VirtualGit/HomeCockpitA320/Images/fcu/pcb-display.png

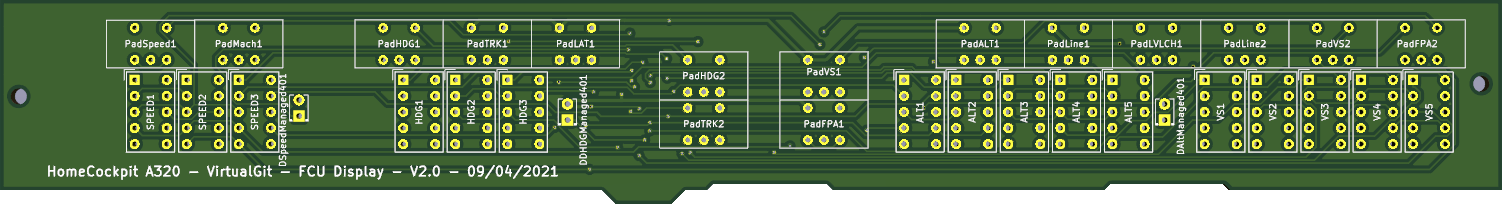
Images/fcu/pcb-display.png
