VirtualGit/HomeCockpitA320/Images/fcu/pcb-mb.png

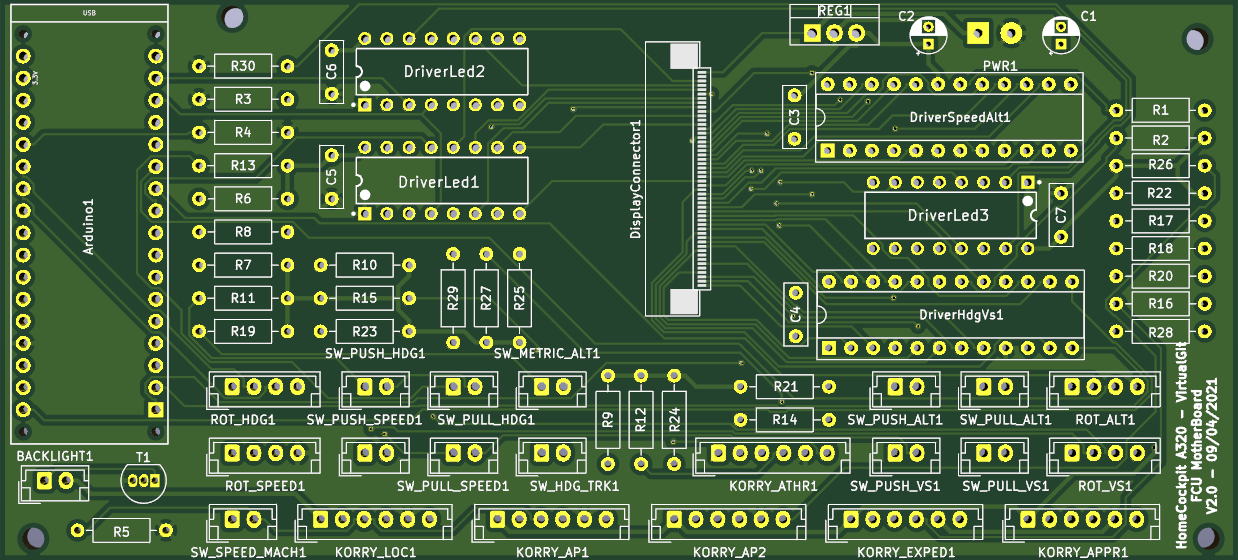
Images/fcu/pcb-mb.png
