VirtualGit/HomeCockpitA320/Electronic/fcu/fcu-mb.kicad_pcb

## KiCad design Electronic/fcu/fcu-mb.kicad_pcb (2021-04-11)

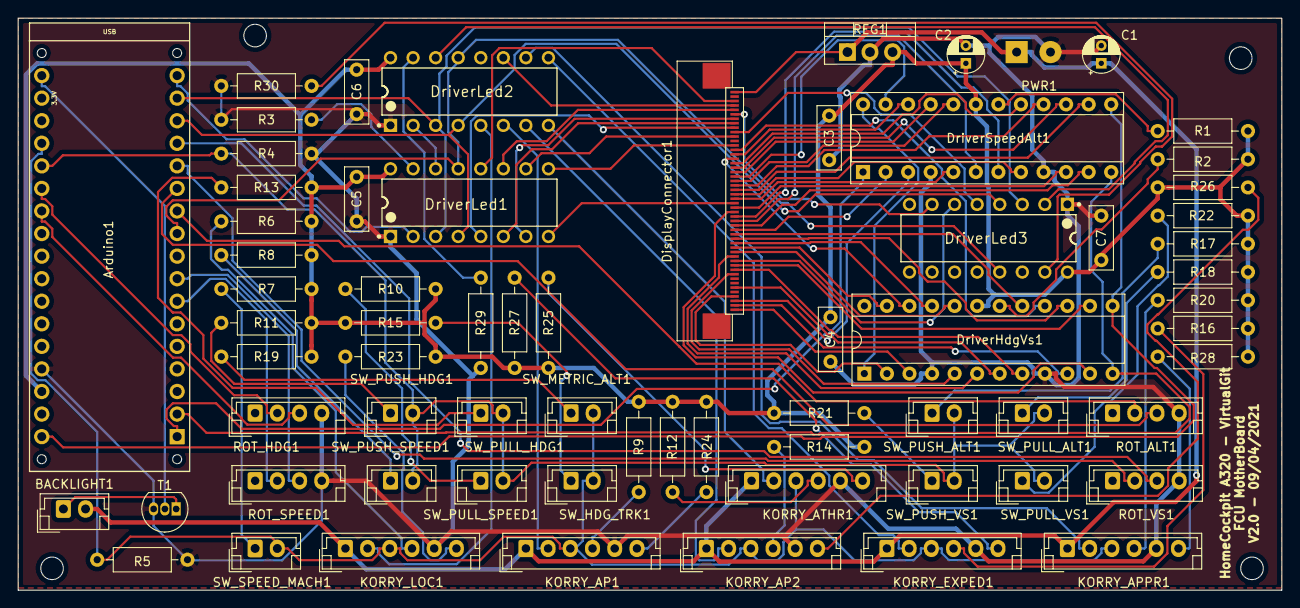
[picture p3: board fcu-mb.kicad_pcb from above]

Board: 2 copper layers, 142.2 x 64.4 mm, 69 parts (0 on the bottom side), 103 nets.

Parts:
Arduino1: Arduino_Nano_v3.x; Arduino_Micro_Socket
BACKLIGHT1: Conn_01x02_Male; JST_EH_B2B-EH-A_1x02_P2.50mm_Vertical
C1: 100µF; CP_Radial_D4.0mm_P2.00mm
C2: 10µF; CP_Radial_D4.0mm_P2.00mm
C3, C4: 0,1µF; C_Disc_D7.0mm_W2.5mm_P5.00mm
C5, C6, C7: 1µF; C_Disc_D7.0mm_W2.5mm_P5.00mm
DisplayConnector1: Connector-FPC-50pins; Connector-FPC-50pins-0.5mm
DriverHdgVs1: MAX7219; DIP-24_W7.62mm_Socket
DriverLed1, DriverLed2, DriverLed3: TLC5917IN; Texas_Instruments-TLC5917IN-Manufacturer_Recommended
DriverSpeedAlt1: MAX7219; DIP-24_W7.62mm_Socket
KORRY_AP1, KORRY_AP2: Korry; JST_EH_B6B-EH-A_1x06_P2.50mm_Vertical
KORRY_APPR1: Korry; JST_EH_B6B-EH-A_1x06_P2.50mm_Vertical
KORRY_ATHR1: Korry; JST_EH_B6B-EH-A_1x06_P2.50mm_Vertical
KORRY_EXPED1: Korry; JST_EH_B6B-EH-A_1x06_P2.50mm_Vertical
KORRY_LOC1: Korry; JST_EH_B6B-EH-A_1x06_P2.50mm_Vertical
PWR1: Conn_Coaxial_Power; SolderWirePad_1x02_P3.81mm_Drill1mm
R1, R2: 9,53kohms; R_Axial_DIN0207_L6.3mm_D2.5mm_P10.16mm_Horizontal
R3, R29: 1kohms; R_Axial_DIN0207_L6.3mm_D2.5mm_P10.16mm_Horizontal
R4, R5: 100kOhms; R_Axial_DIN0207_L6.3mm_D2.5mm_P10.16mm_Horizontal
R6, R13: 33kOhms; R_Axial_DIN0207_L6.3mm_D2.5mm_P10.16mm_Horizontal
R7, R8: 8,2kOhms; R_Axial_DIN0207_L6.3mm_D2.5mm_P10.16mm_Horizontal
R9, R22: 120kOhms; R_Axial_DIN0207_L6.3mm_D2.5mm_P10.16mm_Horizontal
R10, R15: 15kOhms; R_Axial_DIN0207_L6.3mm_D2.5mm_P10.16mm_Horizontal
R11, R19: 22kOhms; R_Axial_DIN0207_L6.3mm_D2.5mm_P10.16mm_Horizontal
R12, R17: 47kOhms; R_Axial_DIN0207_L6.3mm_D2.5mm_P10.16mm_Horizontal
R14: 150kOhms; R_Axial_DIN0207_L6.3mm_D2.5mm_P10.16mm_Horizontal
R16, R18: 68kOhms; R_Axial_DIN0207_L6.3mm_D2.5mm_P10.16mm_Horizontal
R20, R21: 91kOhms; R_Axial_DIN0207_L6.3mm_D2.5mm_P10.16mm_Horizontal
R23, R24, R25, R26, R27, R28: 100Ohms; R_Axial_DIN0207_L6.3mm_D2.5mm_P10.16mm_Horizontal
R30: 2kohms; R_Axial_DIN0207_L6.3mm_D2.5mm_P10.16mm_Horizontal
REG1: L7805; TO-220-3_Vertical
ROT_ALT1: Rotary_Encoder; JST_EH_B4B-EH-A_1x04_P2.50mm_Vertical_RotaryEncoder
ROT_HDG1: Rotary_Encoder; JST_EH_B4B-EH-A_1x04_P2.50mm_Vertical_RotaryEncoder
ROT_SPEED1: Rotary_Encoder; JST_EH_B4B-EH-A_1x04_P2.50mm_Vertical_RotaryEncoder
ROT_VS1: Rotary_Encoder; JST_EH_B4B-EH-A_1x04_P2.50mm_Vertical_RotaryEncoder
SW_HDG_TRK1: SW_Push; JST_EH_B2B-EH-A_1x02_P2.50mm_Vertical
SW_METRIC_ALT1: SW_Push; JST_EH_B2B-EH-A_1x02_P2.50mm_Vertical
SW_PULL_ALT1: SW_Push; JST_EH_B2B-EH-A_1x02_P2.50mm_Vertical
SW_PULL_HDG1: SW_Push; JST_EH_B2B-EH-A_1x02_P2.50mm_Vertical
SW_PULL_SPEED1: SW_Push; JST_EH_B2B-EH-A_1x02_P2.50mm_Vertical
SW_PULL_VS1: SW_Push; JST_EH_B2B-EH-A_1x02_P2.50mm_Vertical
SW_PUSH_ALT1: SW_Push; JST_EH_B2B-EH-A_1x02_P2.50mm_Vertical
SW_PUSH_HDG1: SW_Push; JST_EH_B2B-EH-A_1x02_P2.50mm_Vertical
SW_PUSH_SPEED1: SW_Push; JST_EH_B2B-EH-A_1x02_P2.50mm_Vertical
SW_PUSH_VS1: SW_Push; JST_EH_B2B-EH-A_1x02_P2.50mm_Vertical
SW_SPEED_MACH1: SW_Push; JST_EH_B2B-EH-A_1x02_P2.50mm_Vertical
T1: BS170; TO-92_Inline

Connections:
+5V: Arduino1.VIN, C2.1, C3.1, C4.1, C5.2, C6.2, C7.2, DriverHdgVs1.19, DriverLed1.16, DriverLed2.16, DriverLed3.16, DriverSpeedAlt1.19, R1.1, R2.1, R6.2, R7.2, R8.2, R9.2, R10.2, R11.2, R12.2, R13.2, R14.2, R15.2, R16.2, R17.2, R18.2, R19.2, R20.2, R21.2, R22.2, R23.2, R24.2, R25.2, R26.2, R27.2, R28.2, REG1.3
BTN_GRP_1: Arduino1.A0, KORRY_AP1.3, KORRY_AP2.3, KORRY_APPR1.3, KORRY_ATHR1.3, KORRY_EXPED1.3, KORRY_LOC1.3, R5.2, SW_HDG_TRK1.2, SW_METRIC_ALT1.2, SW_SPEED_MACH1.2
BTN_GRP_2: Arduino1.A1, R4.2, SW_PULL_ALT1.2, SW_PULL_HDG1.2, SW_PULL_SPEED1.2, SW_PULL_VS1.2, SW_PUSH_ALT1.2, SW_PUSH_HDG1.2, SW_PUSH_SPEED1.2, SW_PUSH_VS1.2
DriverDigitClock: Arduino1.SCK, DriverHdgVs1.13, DriverSpeedAlt1.13
DriverDigitData: Arduino1.MOSI, DriverSpeedAlt1.1
DriverDigitLoad: Arduino1.SS, DriverHdgVs1.12, DriverSpeedAlt1.12
DriverLedClock: Arduino1.D11, DriverLed1.3, DriverLed2.3, DriverLed3.3
DriverLedData: Arduino1.D12, DriverLed1.2
DriverLedLoad: Arduino1.D10, DriverLed1.4, DriverLed2.4, DriverLed3.4
GND: Arduino1.GND1, C1.2, C2.2, C3.2, C4.2, C5.1, C6.1, C7.1, DriverHdgVs1.4, DriverHdgVs1.9, DriverLed1.1, DriverLed2.1, DriverLed3.1, DriverSpeedAlt1.4, DriverSpeedAlt1.9, KORRY_AP1.5, KORRY_AP2.5, KORRY_APPR1.5, KORRY_ATHR1.5, KORRY_EXPED1.5, KORRY_LOC1.5, PWR1.2, R3.1, R4.1, R5.1, R29.1, R30.1, REG1.2, ROT_ALT1.C, ROT_HDG1.C, ROT_SPEED1.C, ROT_VS1.C, T1.3
LedKorryAP1: DriverLed2.6, KORRY_AP1.2
LedKorryAP2: DriverLed2.7, KORRY_AP2.2
LedKorryAPPR: DriverLed2.10, KORRY_APPR1.2
LedKorryATHR: DriverLed2.8, KORRY_ATHR1.2
LedKorryEXPED: DriverLed2.9, KORRY_EXPED1.2
LedKorryLoc: DriverLed2.5, KORRY_LOC1.2
LedManagedALT: DisplayConnector1.6, DriverLed3.7
LedManagedHDG: DisplayConnector1.39, DriverLed3.6
LedManagedSpeed: DisplayConnector1.10, DriverLed3.5
LedOutputEnable: Arduino1.D5, DriverLed1.13, DriverLed2.13, DriverLed3.13
LedPadFPA: DisplayConnector1.5, DriverLed1.11
LedPadHDG: DisplayConnector1.7, DriverLed1.7
LedPadLAT: DisplayConnector1.13, DriverLed1.9
LedPadMACH: DisplayConnector1.8, DriverLed1.6
LedPadSPD: DisplayConnector1.9, DriverLed1.5
LedPadStaticALT: DisplayConnector1.3, DriverLed1.12
LedPadStaticLines: DisplayConnector1.4, DriverLed2.11
LedPadTRK: DisplayConnector1.26, DriverLed1.8
LedPadVS: DisplayConnector1.11, DriverLed1.10
unnamed: Arduino1.D13, T1.2
unnamed: BACKLIGHT1.1, T1.1
unnamed: DriverHdgVs1.1, DriverSpeedAlt1.24
unnamed: DriverHdgVs1.18, R2.2
unnamed: DriverLed1.14, DriverLed2.2
unnamed: DriverLed1.15, R3.2
unnamed: DriverLed2.14, DriverLed3.2
unnamed: DriverLed2.15, R29.2
unnamed: DriverLed3.15, R30.2
unnamed: DriverSpeedAlt1.18, R1.2
unnamed: KORRY_AP1.4, R9.1
unnamed: KORRY_AP1.6, R24.1
unnamed: KORRY_AP2.4, R14.1
unnamed: KORRY_AP2.6, R26.1
unnamed: KORRY_APPR1.4, R20.1
unnamed: KORRY_APPR1.6, R28.1
unnamed: KORRY_ATHR1.4, R12.1
unnamed: KORRY_ATHR1.6, R25.1
unnamed: KORRY_EXPED1.4, R16.1
unnamed: KORRY_EXPED1.6, R27.1
unnamed: KORRY_LOC1.4, R6.1
unnamed: KORRY_LOC1.6, R23.1
unnamed: R7.1, SW_SPEED_MACH1.1
unnamed: R8.1, SW_PUSH_SPEED1.1
unnamed: R10.1, SW_PULL_SPEED1.1
unnamed: R11.1, SW_PUSH_HDG1.1
unnamed: R13.1, SW_PULL_HDG1.1
unnamed: R15.1, SW_HDG_TRK1.1
unnamed: R17.1, SW_PUSH_ALT1.1
unnamed: R18.1, SW_PULL_ALT1.1
unnamed: R19.1, SW_METRIC_ALT1.1
unnamed: R21.1, SW_PUSH_VS1.1
unnamed: R22.1, SW_PULL_VS1.1
ROT_ALT_A: Arduino1.D6, ROT_ALT1.A
ROT_ALT_B: Arduino1.D7, ROT_ALT1.B
ROT_HDG_A: Arduino1.A2, ROT_HDG1.A
ROT_HDG_B: Arduino1.A3, ROT_HDG1.B
ROT_SPEED_A: Arduino1.D2, ROT_SPEED1.A
ROT_SPEED_B: Arduino1.D3, ROT_SPEED1.B
ROT_VS_A: Arduino1.D8, ROT_VS1.A
ROT_VS_B: Arduino1.D9, ROT_VS1.B
Vcc12V: BACKLIGHT1.2, C1.1, DisplayConnector1.1, KORRY_AP1.1, KORRY_AP2.1, KORRY_APPR1.1, KORRY_ATHR1.1, KORRY_EXPED1.1, KORRY_LOC1.1, PWR1.1, REG1.1
hdgVsA: DisplayConnector1.40, DriverHdgVs1.14
hdgVsB: DisplayConnector1.14, DriverHdgVs1.16
hdgVsC: DisplayConnector1.37, DriverHdgVs1.20
hdgVsD: DisplayConnector1.36, DriverHdgVs1.23
hdgVsDP: DisplayConnector1.16, DriverHdgVs1.22
hdgVsDig0: DisplayConnector1.47, DriverHdgVs1.2
hdgVsDig1: DisplayConnector1.28, DriverHdgVs1.11
hdgVsDig2: DisplayConnector1.38, DriverHdgVs1.6
hdgVsDig3: DisplayConnector1.45, DriverHdgVs1.7
hdgVsDig4: DisplayConnector1.50, DriverHdgVs1.3
hdgVsDig5: DisplayConnector1.49, DriverHdgVs1.10
hdgVsDig6: DisplayConnector1.42, DriverHdgVs1.5
hdgVsDig7: DisplayConnector1.41, DriverHdgVs1.8
hdgVsE: DisplayConnector1.35, DriverHdgVs1.21
hdgVsF: DisplayConnector1.34, DriverHdgVs1.15
hdgVsG: DisplayConnector1.33, DriverHdgVs1.17
speedAltA: DisplayConnector1.23, DriverSpeedAlt1.14
speedAltB: DisplayConnector1.22, DriverSpeedAlt1.16
speedAltC: DisplayConnector1.21, DriverSpeedAlt1.20
speedAltD: DisplayConnector1.20, DriverSpeedAlt1.23
speedAltDP: DisplayConnector1.15, DriverSpeedAlt1.22
speedAltDig0: DisplayConnector1.32, DriverSpeedAlt1.2
speedAltDig1: DisplayConnector1.31, DriverSpeedAlt1.11
speedAltDig2: DisplayConnector1.30, DriverSpeedAlt1.6
speedAltDig3: DisplayConnector1.29, DriverSpeedAlt1.7
speedAltDig4: DisplayConnector1.48, DriverSpeedAlt1.3
speedAltDig5: DisplayConnector1.27, DriverSpeedAlt1.10
speedAltDig6: DisplayConnector1.25, DriverSpeedAlt1.5
speedAltDig7: DisplayConnector1.24, DriverSpeedAlt1.8
speedAltE: DisplayConnector1.19, DriverSpeedAlt1.21
speedAltF: DisplayConnector1.18, DriverSpeedAlt1.15
speedAltG: DisplayConnector1.17, DriverSpeedAlt1.17
