VirtualGit/HomeCockpitA320/Electronic/fcu/fcu-display.kicad_pcb

## KiCad design Electronic/fcu/fcu-display.kicad_pcb (2021-04-11)

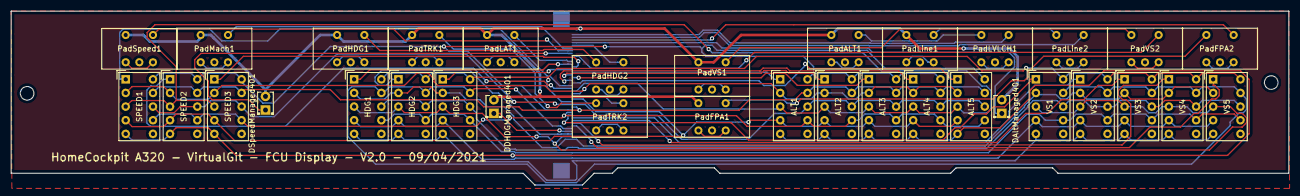
[picture p4: board fcu-display.kicad_pcb from above]

Board: 2 copper layers, 238.0 x 32.4 mm, 35 parts (1 on the bottom side), 66 nets.

Parts:
ALT1, ALT2, ALT3, ALT4, ALT5: HDSP-7401
DAltManaged401: LED; LED_D2.0mm_W4.0mm_H2.8mm_FlatTop
DDHDGManaged401: LED; LED_D2.0mm_W4.0mm_H2.8mm_FlatTop
DSpeedManaged401: LED; LED_D2.0mm_W4.0mm_H2.8mm_FlatTop
DisplayConnector1: Connector-FPC-50pins; Connector-FPC-50pins-0.5mm
HDG1, HDG2, HDG3: HDSP-7401
PadALT1: LedPad; PadLed-KingBright-DE-2YD
PadFPA1, PadFPA2: LedPad; PadLed-KingBright-DE-2YD
PadHDG1, PadHDG2: LedPad; PadLed-KingBright-DE-2YD
PadLAT1: LedPad; PadLed-KingBright-DE-2YD
PadLVLCH1: LedPad; PadLed-KingBright-DE-2YD
PadLine1, PadLine2: LedPad; PadLed-KingBright-DE-2YD
PadMach1: LedPad; PadLed-KingBright-DE-2YD
PadSpeed1: LedPad; PadLed-KingBright-DE-2YD
PadTRK1, PadTRK2: LedPad; PadLed-KingBright-DE-2YD
PadVS1, PadVS2: LedPad; PadLed-KingBright-DE-2YD
SPEED1, SPEED2, SPEED3: HDSP-7401
VS1, VS2, VS3, VS4, VS5: HDSP-7401

Connections:
LedManagedALT: DAltManaged401.1, DisplayConnector1.45
LedManagedHDG: DDHDGManaged401.1, DisplayConnector1.12
LedManagedSpeed: DSpeedManaged401.1, DisplayConnector1.41
LedPadFPA: DisplayConnector1.46, PadFPA2.1
LedPadHDG: DisplayConnector1.44, PadHDG2.1
LedPadLAT: DisplayConnector1.38, PadLAT1.1
LedPadMACH: DisplayConnector1.43, PadMach1.1
LedPadSPD: DisplayConnector1.42, PadSpeed1.1
LedPadStaticALT: DisplayConnector1.48, PadLVLCH1.1
LedPadStaticLines: DisplayConnector1.47, PadLine2.1
LedPadTRK: DisplayConnector1.25, PadTRK2.1
LedPadVS: DisplayConnector1.40, PadVS2.1
unnamed: PadALT1.1, PadLVLCH1.3
unnamed: PadALT1.4, PadALT1.6
unnamed: PadFPA1.1, PadFPA2.3
unnamed: PadFPA1.4, PadFPA1.6
unnamed: PadFPA2.4, PadFPA2.6
unnamed: PadHDG1.1, PadHDG2.3
unnamed: PadHDG1.4, PadHDG1.6
unnamed: PadHDG2.4, PadHDG2.6
unnamed: PadLAT1.4, PadLAT1.6
unnamed: PadLVLCH1.4, PadLVLCH1.6
unnamed: PadLine1.1, PadLine2.3
unnamed: PadLine1.4, PadLine1.6
unnamed: PadLine2.4, PadLine2.6
unnamed: PadMach1.4, PadMach1.6
unnamed: PadSpeed1.4, PadSpeed1.6
unnamed: PadTRK1.1, PadTRK2.3
unnamed: PadTRK1.4, PadTRK1.6
unnamed: PadTRK2.4, PadTRK2.6
unnamed: PadVS1.1, PadVS2.3
unnamed: PadVS1.4, PadVS1.6
unnamed: PadVS2.4, PadVS2.6
Vcc12V: DAltManaged401.2, DDHDGManaged401.2, DSpeedManaged401.2, DisplayConnector1.50, PadALT1.3, PadFPA1.3, PadHDG1.3, PadLAT1.3, PadLine1.3, PadMach1.3, PadSpeed1.3, PadTRK1.3, PadVS1.3
hdgVsA: DisplayConnector1.11, HDG2.1
hdgVsB: DisplayConnector1.37, HDG1.1
hdgVsC: DisplayConnector1.14, VS5.1
hdgVsD: DisplayConnector1.15, VS4.1
hdgVsDP: DisplayConnector1.35, HDG3.1
hdgVsDig0: DisplayConnector1.4, HDG1.7, HDG2.7, HDG3.7, VS1.7, VS2.7, VS3.7, VS4.7, VS5.7
hdgVsDig1: DisplayConnector1.23, HDG1.10, HDG2.10, HDG3.10, VS1.10, VS2.10, VS3.10, VS4.10, VS5.10
hdgVsDig2: DisplayConnector1.13, HDG1.9, HDG2.9, HDG3.9, VS1.9, VS2.9, VS3.9, VS4.9, VS5.9
hdgVsDig3: DisplayConnector1.6, HDG1.8, HDG2.8, HDG3.8, VS1.8, VS2.8, VS3.8, VS4.8, VS5.8
hdgVsDig4: DisplayConnector1.1, HDG1.5, HDG2.5, HDG3.5, VS1.5, VS2.5, VS3.5, VS4.5, VS5.5
hdgVsDig5: DisplayConnector1.2, HDG1.4, HDG2.4, HDG3.4, VS1.4, VS2.4, VS3.4, VS4.4, VS5.4
hdgVsDig6: DisplayConnector1.9, HDG1.2, HDG2.2, HDG3.2, VS1.2, VS2.2, VS3.2, VS4.2, VS5.2
hdgVsDig7: DisplayConnector1.10, HDG1.3, HDG2.3, HDG3.3, VS1.3, VS2.3, VS3.3, VS4.3, VS5.3
hdgVsE: DisplayConnector1.16, VS3.1
hdgVsF: DisplayConnector1.17, VS2.1
hdgVsG: DisplayConnector1.18, VS1.1
speedAltA: DisplayConnector1.28, SPEED2.1
speedAltB: DisplayConnector1.29, SPEED1.1
speedAltC: ALT5.1, DisplayConnector1.30
speedAltD: ALT4.1, DisplayConnector1.31
speedAltDP: DisplayConnector1.36, SPEED3.1
speedAltDig0: ALT1.7, ALT2.7, ALT3.7, ALT4.7, ALT5.7, DisplayConnector1.19, SPEED1.7, SPEED2.7, SPEED3.7
speedAltDig1: ALT1.10, ALT2.10, ALT3.10, ALT4.10, ALT5.10, DisplayConnector1.20, SPEED1.10, SPEED2.10, SPEED3.10
speedAltDig2: ALT1.9, ALT2.9, ALT3.9, ALT4.9, ALT5.9, DisplayConnector1.21, SPEED1.9, SPEED2.9, SPEED3.9
speedAltDig3: ALT1.8, ALT2.8, ALT3.8, ALT4.8, ALT5.8, DisplayConnector1.22, SPEED1.8, SPEED2.8, SPEED3.8
speedAltDig4: ALT1.5, ALT2.5, ALT3.5, ALT4.5, ALT5.5, DisplayConnector1.3, SPEED1.5, SPEED2.5, SPEED3.5
speedAltDig5: ALT1.4, ALT2.4, ALT3.4, ALT4.4, ALT5.4, DisplayConnector1.24, SPEED1.4, SPEED2.4, SPEED3.4
speedAltDig6: ALT1.2, ALT2.2, ALT3.2, ALT4.2, ALT5.2, DisplayConnector1.26, SPEED1.2, SPEED2.2, SPEED3.2
speedAltDig7: ALT1.3, ALT2.3, ALT3.3, ALT4.3, ALT5.3, DisplayConnector1.27, SPEED1.3, SPEED2.3, SPEED3.3
speedAltE: ALT3.1, DisplayConnector1.32
speedAltF: ALT2.1, DisplayConnector1.33
speedAltG: ALT1.1, DisplayConnector1.34
