VirtualGit/HomeCockpitA320/Programming/JHBridge/Message.cpp

#include "Message.h"

#include <sstream>
#include <QRegExp>

using std::ostringstream;



Message Message::fromSerial(QString data)
{
    QRegExp pattern("([^=]+)=(-?[0-9]+)");
    int pos = pattern.indexIn(data);
    if (pos > -1) {
        int id = pattern.cap(1).toInt();
        QString value = pattern.cap(2);
        return Message(id, value);
    }
    else
    {
        //TODO throw exception
        return Message(-1,"");
    }
}

Message Message::fromTCP(QString data)
{
    QRegExp pattern("Arn.Resp:([0-9]+)=([^:]+):");
    int pos = pattern.indexIn(data);
    if (pos > -1) {
        int id = pattern.cap(1).toInt();
        QString value = pattern.cap(2);
        return Message(id, value);
    }
    else
    {
        //TODO throw exception
        return Message(-1,"");
    }
}

QString Message::toTCP() const
{
    ostringstream oss;
    oss << "Arn.Resp:" << _id << "=" << _value.toStdString() << ":\r\n";
    return QString(oss.str().c_str());
}

QString Message::toSerial() const
{
    return QString().number(_id) + "=" + _value + "\n";
}
