VirtualGit/HomeCockpitA320/(commit log)

2020-02-03 Add FCU schema and board, display part.
    [fcu-display.brd, fcu-display.sch]
2021-02-13 First FCU draft with KiCad
    [efis.sch, fcu.kicad_pcb, fcu.sch]
2021-02-16 First draft complete for FCU MB (MotherBoard) and FCU Display.
    [fcu-display-driver1.sch, fcu-display-driver2.sch, fcu-display-driver3.sch, fcu-display.kicad_pcb, fcu-display.sch, fcu-mb-control.sch, fcu-mb-display-drivers.sch, fcu-mb.dsn]
2021-02-16 Remove old electronic files (Eagle)
    [fcu-display.brd, fcu-display.sch]
2021-02-16 Rename Electronic directory
    [efis.sch, fcu-display-driver1.sch, fcu-display-driver2.sch, fcu-display-driver3.sch, fcu-display.kicad_pcb, fcu-display.sch, fcu-mb-control.sch, fcu-mb-display-drivers.sch]
2021-02-17 Remove draft schema
    [fcu.kicad_pcb, fcu.sch]
2021-02-17 Remove undesired, generated files
    [fcu-mb.dsn]
2021-02-17 Update fcu schemas and libraries
    [fcu-display-driver1.sch, fcu-display-driver2.sch, fcu-display-driver3.sch, fcu-display.kicad_pcb, fcu-display.sch, fcu-mb.kicad_pcb, fcu-mb.sch]
2021-02-17 Update references to symbol in right library
    [fcu-display-driver3.sch]
2021-02-17 Update FCU display board with routing
    [fcu-display.kicad_pcb]
2021-02-17 Adust fcu display pcb layout Add Vcc to rotary encoder and update pcb with jst +1 pin
    [fcu-display.kicad_pcb, fcu-mb-control.sch, fcu-mb.kicad_pcb, fcu-mb.sch]
2021-02-20 Add first arduino libraries and test fcu file
2021-02-20 Add JHBridge software first draft version
    [parameters.csv]
2021-02-21 Update JHBridge and JHArduino library to remove variable names
    Update JHBridge and JHArduino library to remove variable names and use
    an enum instead. All JeeHell parameters are in parameters.json. This
    file is the reference, from it, the parameters.h of JHArudino is
    generated. parameter.json is also used by JHBridge to generate JeeHell
    FMGSserver.iocp.ini file for a given board configuration (boards must be
    connected at the generation time to know which parameter are used and
    must be provided by JH SIOC interface)
2021-02-21 Update SerialPort reading, because in case of quick new lines, readLine may stop in the middle of one line
2021-02-21 Update JHArduino library to send new values (buttons, then rotary encoders)
2021-02-21 Update fcu arduino test to add a button
2021-02-21 Add rotary encoder library
2021-02-21 Add a rotary encoder to the fcu test arduino project
2021-02-21 Add Arduino micro symbol and footprint
2021-02-23 Update FCU PCB net routing
    [fcu-display.kicad_pcb, fcu-mb.kicad_pcb, fcu-mb.sch]
2021-02-25 Finalise first FCU PCB version
    [fcu-display.kicad_pcb, fcu-mb-control.sch, fcu-mb-display-drivers.sch, fcu-mb.kicad_pcb, fcu-mb.sch]
2021-02-25 Ignore gerber files
2021-04-02 switch types from int to long
2021-04-02 Update LedControl lib for improving common anode behavior.
2021-04-02 Update fcu arduino soft : digits and rotary encoders are ok
2021-04-07 Change the way JHBridge handle SIOCVariable to allow correct export to both Arduino library and FMGS config file
    [SIOCCatalog.cpp]
2021-04-11 Update electornic schema of FCU MotherBoard and Display. Replace MAX7219 for leds to dedicated TLC5917.
    [fcu-display-driver3.sch, fcu-display.kicad_pcb, fcu-display.sch, fcu-mb-control.sch, fcu-mb-display-drivers.sch, fcu-mb.kicad_pcb, fcu-mb.sch]
2021-04-11 Adjust resistor values for TLC5917
    [fcu-display.kicad_pcb, fcu-mb-display-drivers.sch, fcu-mb.kicad_pcb]
2021-04-11 PCB changed after gerber export
    [fcu-display.kicad_pcb, fcu-mb.kicad_pcb]
2021-04-11 Add FCU PCB images
